OipRDDinoSaric/Complex-system-for-powering-digital-circuits-and-analogue-circuits-susceptible-to-noise/BoM_Zavrsni_rad[2018]Dino_Saric.xlsx

Value | Designator | Description | Case Style | Manufacturer | Order Code | Quantity | Price, GBP | Total price | Link:
 | U4 | LM2675M-5.0 - Buck (Step Down) Switching Regulator, Fixed, 6.5V-40V In, 5V And 1A Out, SOIC-8 | SOIC-8 | TEXAS INSTRUMENTS | 9489746 | 2 | 4,21 | 8.42 | http://export.farnell.com/texas-instruments/lm2675m-5-0/switching-reg-1a-5-0v-smd-2675/dp/9489746?st=LM2675
100u | L2 | SRF0703A-101M - Inductor, Coupled, 100 µH, 20%, 0.715 ohm, 730 mA, 7.6mm x 7.6mm x 3.4mm | Datasheet | BOURNS | 2455003 | 2 | 0,863 | 1.726 | http://export.farnell.com/bourns/srf0703a-101m/inductor-coupled-100uh-20-0-73a/dp/2455003
47u | C10 | C1210C476M9PACTU - SMD Multilayer Ceramic Capacitor, 1210 [3225 Metric], 47 µF, 6.3 V, ± 20%, X5R, C Series | 1210 | KEMET | 1108327 | 2 | 0,897 | 1.794 | http://export.farnell.com/kemet/c1210c476m9pactu/cap-mlcc-x5r-47uf-6-3v-1210/dp/1108327
- | D4 | NSVBAT54LT1G - Small Signal Schottky Diode, Single, 30 V, 200 mA, 800 mV, 600 mA, 150 °C | SOT-23 | ON SEMICONDUCTOR | 2774594 | 5 | 0,0366 | 0.183 | http://export.farnell.com/on-semiconductor/nsvbat54lt1g/diode-schottky-aec-q101-30v-sot/dp/2774594
100u | C9 | TPSD107K010R0100... - Surface Mount Tantalum Capacitor, 100 µF, 10 V, TPS Series, ± 10%, 2917 [7343 Metric] | 2917 | AVX | 1462462 | 2 | 0,922 | 1.844 | http://export.farnell.com/avx/tpsd107k010r0100/cap-tant-100uf-10v-case-d/dp/1462462
0,01u | C8 | 0603B103K250CT - SMD Multilayer Ceramic Capacitor, 0603 [1608 Metric], 0.01 µF, 25 V, ± 10%, X7R | 0603 | WALSIN | 2496827 | 10 | 0,0129 | 0.129 | http://export.farnell.com/walsin/0603b103k250ct/capacitor-mlcc-x7r-0-01uf-25v/dp/2496827
 |  |  |  |  |  |  |  | 0
 | U1 | TL2575-12IKTTR - Buck (Step Down) Switching Regulator, Fixed, 4.75V-40V In, 12V And 1A Out, TO-263-5 | T0-263-5 | TEXAS INSTRUMENTS | 1755279 | 2 | 1,69 | 3.38 | http://export.farnell.com/texas-instruments/tl2575-12ikttr/ic-stp-dwn-sw-v-reg-12v-d2pak/dp/1755279?st=TL2575
100u | C1 | EEEFPV101XAP - SMD Aluminium Electrolytic Capacitor, Radial Can - SMD, 100 µF, 35 V, 0.16 ohm, FP Series | Datasheet | PANASONIC ELECTRONIC COMPONENTS | 1539501 | 2 | 0,395 | 0.79 | http://export.farnell.com/panasonic-electronic-components/eeefpv101xap/cap-alu-elec-100uf-35v-smd/dp/1539501
470u | C2 | EEEFK1V471SP - SMD Aluminium Electrolytic Capacitor, Radial Can - SMD, 470 µF, 35 V, 0.08 ohm, FKS Series | Datasheet | PANASONIC ELECTRONIC COMPONENTS | 2507737 | 2 | 0,959 | 1.918 | http://export.farnell.com/panasonic-electronic-components/eeefk1v471sp/cap-alu-elec-470uf-35v-rad-can/dp/2507737
- | D1 | Kao D4 u retku 6 | SOT-23 | ON SEMICONDUCTOR | 2774594 | 0 | 0,0366 | 0 | http://export.farnell.com/on-semiconductor/nsvbat54lt1g/diode-schottky-aec-q101-30v-sot/dp/2774594
680u | L1 | MSS1278T-684KLB - Power Inductor (SMD), 680 µH, 750 µA, Shielded, 1.24 A, MSS1278T Series, 12mm x 12mm x 7.8mm | Datasheet | COILCRAFT | 2288523 | 2 | 0,804 | 1.608 | http://export.farnell.com/coilcraft/mss1278t-684klb/inductor-pwr-680uh-0-75a-10-1/dp/2288523
 |  |  |  |  |  |  |  | 0
- | U2 | LP2992AIM5-5.0/NOPB - Fixed LDO Voltage Regulator, 2.2V to 16V, 450mV Dropout, 5Vout, 250mAout, SOT-23-5 | SOT-23 | TEXAS INSTRUMENTS | 1685561 | 2 | 0,818 | 1.636 | http://export.farnell.com/texas-instruments/lp2992aim5-5-0-nopb/ic-ldo-reg/dp/1685561?st=LP2992
0,1u | C4 | VJ0805Y104JCAAJ - SMD Multilayer Ceramic Capacitor, IR Reflow, 0805 [2012 Metric], 0.1 µF, 50 V, ± 5%, X7R | 0805 | VISHAY | 2672814 | 2 | 0,361 | 0.722 | http://export.farnell.com/vishay/vj0805y104jcaaj/cap-mlcc-x7r-0-1uf-50v-0805/dp/2672814
47u | C6 | C1210C476M9PACTU - SMD Multilayer Ceramic Capacitor, 1210 [3225 Metric], 47 µF, 6.3 V, ± 20%, X5R, C Series | 1210 | KEMET | 1108327 | 2 | 0,897 | 1.794 | http://export.farnell.com/kemet/c1210c476m9pactu/cap-mlcc-x5r-47uf-6-3v-1210/dp/1108327
10u | C5 | 1210X106K250CT - SMD Multilayer Ceramic Capacitor, 1210 [3225 Metric], 10 µF, 25 V, ± 10%, X5R | 1210 | WALSIN | 2497182 | 2 | 0,419 | 0.838 | http://export.farnell.com/walsin/1210x106k250ct/capacitor-mlcc-x5r-10uf-25v-1210/dp/2497182
 |  |  |  |  |  |  |  | 0
- | U3 | PIC16F1459-I/P - 8 Bit Microcontroller, Flash, PIC16F145x, 48 MHz, 14 KB, 1 KB, 20 Pins, DIP | DIP-20 | MICROCHIP | 2305816 | 2 | 1,81 | 3.62 | http://export.farnell.com/microchip/pic16f1459-i-p/mcu-8bit-pic16-48mhz-dip-20/dp/2305816
0,1u | C3 | VJ0805Y104JCAAJ - SMD Multilayer Ceramic Capacitor, IR Reflow, 0805 [2012 Metric], 0.1 µF, 50 V, ± 5%, X7R | 0805 | VISHAY | 2672814 | 2 | 0,361 | 0.722 | http://export.farnell.com/vishay/vj0805y104jcaaj/cap-mlcc-x7r-0-1uf-50v-0805/dp/2672814
470n | C7 | 885012007025 - SMD Multilayer Ceramic Capacitor, 0805 [2012 Metric], 4700 pF, 16 V, ± 5%, C0G / NP0 | 0805 | WURTH ELEKTRONIK | 2812146 | 5 | 0,124 | 0.62 | http://export.farnell.com/wurth-elektronik/885012007025/cap-mlcc-c0g-4700pf-16v-0805/dp/2812146
- | J1, J2, J4, J5, J6, J7, J9, J10 | 2211S-02G - Board-To-Board Connector, Vertical, 2.54 mm, 2 Contacts, Header, 2211S Series, Through Hole, 1 Rows | Through hole, 01x02, 2,54 mm | MULTICOMP | 1593411 | 16 | 0,0204 | 0.3264 | http://export.farnell.com/multicomp/2211s-02g/header-1-row-vert-2way/dp/1593411
- | J8 | TSM-106-01-L-SH - Board-To-Board Connector, 2.54 mm, 6 Contacts, Header, TSM Series, Surface Mount, 1 Rows | Through hole, 01x06, 2,54 mm | SAMTEC | 2667444 | 2 | 0,671 | 1.342 | http://export.farnell.com/samtec/tsm-106-01-l-sh/connector-header-6pos-1row-2-54mm/dp/2667444
- | J12 | 90120-0768 - Board-To-Board Connector, Vertical, 2.54 mm, 8 Contacts, Header, C-Grid III 90120 Series | Through hole, 01x08, 2,54 mm | MOLEX | 9733345 | 2 | 0,45 | 0.9 | http://export.farnell.com/molex/90120-0768/header-vertical-1row-8way/dp/9733345
- | J11 | 2211S-03G - Board-To-Board Connector, Vertical, 2.54 mm, 3 Contacts, Header, 2211S Series, Through Hole, 1 Rows | Through hole, 01x03, 2,54 mm | MULTICOMP | 1593412 | 2 | 0,0269 | 0.0538 | http://export.farnell.com/multicomp/2211s-03g/header-1-row-vert-3way/dp/1593412
- | J3 | ZX62-B-5PA(33) - USB Connector, Micro USB Type B, USB 2.0, Receptacle, 5 Ways, Surface Mount, Right Angle | Surface Mount, Right Angle | HIROSE(HRS) | 2554978 | 2 | 0,38 | 0.76 | http://export.farnell.com/hirose-hrs/zx62-b-5pa-33/micro-usb-2-0-type-b-rcpt-smt/dp/2554978
- | D2, D3 | KPT-1608EC - LED, Low Power, Red, SMD, 0.8mm x 1.6mm, 20 mA, 2 V, 617 nm | 0603 | KINGBRIGHT | 2099221 | 5 | 0,0375 | 0.1875 | http://export.farnell.com/kingbright/kpt-1608ec/led-0603-red-15mcd-625nm/dp/2099221
150 | R1, R2 | MCWR08X1500FTL - SMD Chip Resistor, 150 ohm, MCWR Series, 150 V, Thick Film, 0805 [2012 Metric], 125 mW | 0805 | MULTICOMP | 2447574 | 10 | 0,006 | 0.06 | http://export.farnell.com/multicomp/mcwr08x1500ftl/res-thick-film-150r-1-0-125w-0805/dp/2447574
- | U3 | 2227MC-20-03-07-F1 - IC & Component Socket, 20 Contacts, DIP Socket, 2.54 mm, 2227MC Series, 7.62 mm, Phosphor Bronze | DIP-20 | MULTICOMP | 1103848 | 2 | 0,457 | 0.914 | http://export.farnell.com/multicomp/2227mc-20-03-07-f1/socket-ic-dil-0-3-20way/dp/1103848
 |  |  |  |  |  |  |  | 0
1,6k | R3 | MCMR04X162 JTL - SMD Chip Resistor, Ceramic, 1.6 kohm, MCMR Series, 50 V, Thick Film, 0402 [1005 Metric], 62.5 mW | 0402 | MULTICOMP | 2072674 | 10 | 0,0017 | 0.017 | http://export.farnell.com/multicomp/mcmr04x162-jtl/res-ceramic-1k6-5-0-0625w-0402/dp/2072674
- | D5, D6 | LGT67K-H2K1-24-Z - LED, Hyper TOPLED®, Green, SMD, 2.4mm, 2 mA, 1.8 V, 570 nm | Datasheet | OSRAM | 1226376 | 5 | 0,174 | 0.87 | http://export.farnell.com/osram/lgt67k-h2k1-24-z/led-smd-green-9mcd-570nm/dp/1226376
5,1k | R4 | MCWR08X5101FTL - SMD Chip Resistor, 5.1 kohm, MCWR Series, 150 V, Thick Film, 0805 [2012 Metric], 125 mW | 0805 | MULTICOMP | 2447692 | 10 | 0,006 | 0.06 | http://export.farnell.com/multicomp/mcwr08x5101ftl/res-thick-film-5k1-1-0-125w-0805/dp/2447692
 |  |  |  |  |  |  |  | 0
 |  |  |  |  |  |  |  | 0
 |  |  |  |  |  |  |  | 0
 |  |  |  |  |  |  | SUMA, GPB | 37.2347
