OipRDDinoSaric/Complex-system-for-powering-digital-circuits-and-analogue-circuits-susceptible-to-noise/Dodatni_BoM_Zavrsni_rad[2018]Dino_Saric.xlsx

Value | Designator | Description | Case Style | Manufacturer | Order Code | Quantity | Price, GBP | Total price, GPB | Link:
0,1u | C3 | MC0402B104J160CT - SMD Multilayer Ceramic Capacitor, 0402 [1005 Metric], 0.1 µF, 16 V, ± 5%, X7R, MC Series | 0402 | MULTICOMP | 2627342 | 10 | 0.0141 | 0.141 | http://export.farnell.com/multicomp/mc0402b104j160ct/cap-mlcc-x7r-0-1uf-16v-0402/dp/2627342
5,1K | R4 | ERJ2GEJ512X - SMD Chip Resistor, 5.1 kohm, ERJ2G Series, 50 V, Thick Film, 0402 [1005 Metric], 100 mW | 0402 | PANASONIC | 2059235 | 10 | 0.0173 | 0.173 | http://export.farnell.com/panasonic-electronic-components/erj2gej512x/res-thick-film-5k1-5-0-1w-0402/dp/2059235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
0,1u | C3 | ZAMJENSKA - MC0402X104K100CT - SMD Multilayer Ceramic Capacitor, 0402 [1005 Metric], 0.1 µF, 10 V, ± 10%, X5R, MC Series | 0402 | MULTICOMP | 1759380 | 10 | 0.0092 | 0.092 | http://export.farnell.com/multicomp/mc0402x104k100ct/cap-mlcc-x5r-100nf-10v-0402/dp/1759380
10,2k | R4 | Za 2 u paralelu - ERJ2RKF1022X - SMD Chip Resistor, 10.2 kohm, ERJ2R Series, 50 V, Thick Film, 0402 [1005 Metric], 100 mW | 0402 | PANASONIC ELECTRONIC COMPONENTS | 2302740 | 10 | 0.023 | 0.23 | http://export.farnell.com/te-connectivity/rp73pf1e10k2btdf/res-thin-film-10k2-0-1-0-1w-0402/dp/2838466RL
15,4k | R4 | Za 3 u paralelu - SMD Chip Resistor, 15.4 kohm, ERJ2R Series, 50 V, Thick Film, 0402 [1005 Metric], 100 mW | 0402 | PANASONIC ELECTRONIC COMPONENTS | 2302756 | 10 | 0,0207 | 0.207 | http://export.farnell.com/panasonic-electronic-components/erj2rkf1542x/res-thick-film-15k4-1-0-1w-0402/dp/2302756
5,1k | R4 | through hole - MCMF006FF5101A50 - Through Hole Resistor, 5.1 kohm, MCMF Series, 600 mW, ± 1%, Axial Leaded, 250 V | Through Hole | MULTICOMP | 2401773 | 10 | 0.0269 | 0.269 | http://export.farnell.com/multicomp/mcmf006ff5101a50/resistor-metal-film-5-1kohm-1/dp/2401773
 |  |  |  |  |  |  | SUMA | 1.112
