OipRDDinoSaric/Complex-system-for-powering-digital-circuits-and-analogue-circuits-susceptible-to-noise/(list of files, cad)

Other CAD files:
Upravljanje/Backup - problemi/MPLAB/USB-to-SPI.x/dist/LPCUSBDK_16F1459/production/USB-to-SPI.x.production.obj
Upravljanje/MPLAB/ADC/ADC.X/dist/LPCUSBDK_16F1459/production/USB-to-SPI.x.production.obj
Upravljanje/MPLAB/ADC/ADC.X/dist/LPCUSBDK_16F1459/production/ADC.X.production.obj
