OipRDDinoSaric/Complex-system-for-powering-digital-circuits-and-analogue-circuits-susceptible-to-noise/KiCad/Zavrsni.kicad_pcb

## KiCad design KiCad/Zavrsni.kicad_pcb (2018-10-11)

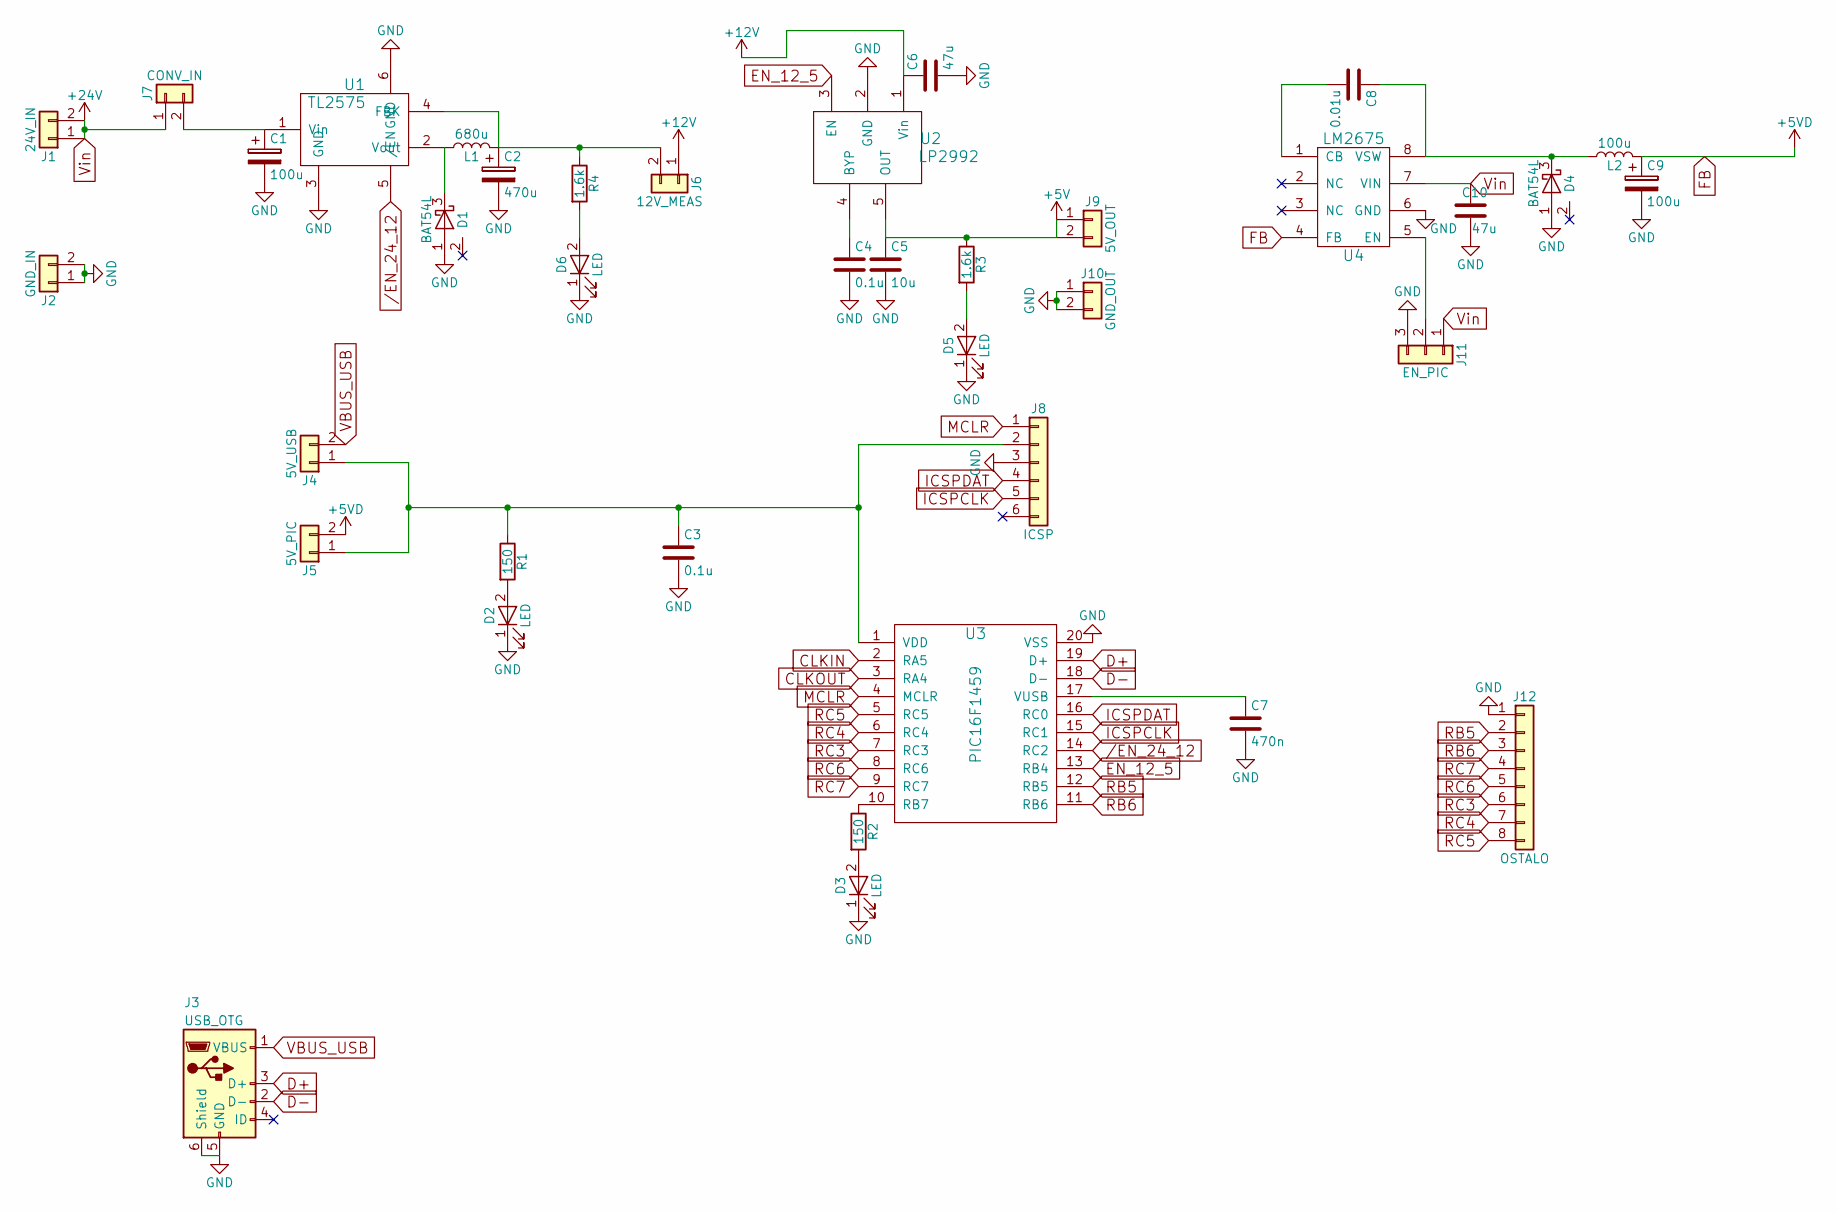
[picture p27: schematic Zavrsni.sch]

Parts:
C1: 100u; CP_Elec_6.3x7.7
C2: 470u; CP_Elec_10x10.5
C3: 0.1u; C_0402
C4: 0.1u; C_0805_HandSoldering
C5: 10u; C_1210_HandSoldering
C6, C10: 47u; C_1210_HandSoldering
C7: 470n; C_0805_HandSoldering
C8: 0.01u; C_0603_HandSoldering
C9: 100u; SM2917_POL
D1, D4: BAT54L; SOT-23_Handsoldering
D2, D3: LED; C_0603_HandSoldering
D5, D6: LED; Zelena dioda
J1: 24V_IN; Pin_Header_Straight_1x02_Pitch2.54mm
J2: GND_IN; Pin_Header_Straight_1x02_Pitch2.54mm
J3: USB_OTG; USB_Micro-B
J4: 5V_USB; Pin_Header_Straight_1x02_Pitch2.54mm
J5: 5V_PIC; Pin_Header_Straight_1x02_Pitch2.54mm
J6: 12V_MEAS; Pin_Header_Straight_1x02_Pitch2.54mm
J7: CONV_IN; Pin_Header_Straight_1x02_Pitch2.54mm
J8: ICSP; Pin_Header_Straight_1x06_Pitch2.54mm
J9: 5V_OUT; Pin_Header_Straight_1x02_Pitch2.54mm
J10: GND_OUT; Pin_Header_Straight_1x02_Pitch2.54mm
J11: EN_PIC; Pin_Header_Straight_1x03_Pitch2.54mm
J12: OSTALO; Pin_Header_Straight_1x08_Pitch2.54mm
L1: 680u; Coilcraft MSS1278T-684KLB 680uH
L2: 100u; Bourns_SRF0703A-101M_100u
R1, R2: 150; R_0805_HandSoldering
R3, R4: 1.6k; R_0402
U1: TL2575; TO-263-5
U2: LP2992; SOT-23-5_HandSoldering
U3: PIC16F1459; DIP-20_W7.62mm_LongPads
U4: LM2675; SOIC-8_3.9x4.9mm_Pitch1.27mm

Connections:
+5V: C5.1, J9.1, J9.2, R3.1, U2.5 (OUT)
+12V: C6.1, J6.1, U2.1 (Vin)
/EN_24_12: U1.5 (/EN), U3.14 (RC2)
CLKIN: U3.2 (RA5)
CLKOUT: U3.3 (RA4)
D+: J3.3 (D+), U3.19 (D+)
D-: J3.2 (D-), U3.18 (D-)
EN_12_5: U2.3 (EN), U3.13 (RB4)
FB: C9.1, J5.2, L2.2, U4.4 (FB)
GND: C1.2, C2.2, C3.2, C4.2, C5.2, C6.2, C7.2, C9.2, C10.1, D1.1 (A), D2.1 (K), D3.1 (K), D4.1 (A), D5.1 (K), D6.1 (K), J2.1, J2.2, J3.5 (GND), J3.6 (Shield), J8.3, J10.1, J10.2, J11.3, J12.1, U1.3 (GND), U1.6 (GND), U2.2 (GND), U3.20 (VSS), U4.6 (GND)
ICSPCLK: J8.5, U3.15 (RC1)
ICSPDAT: J8.4, U3.16 (RC0)
MCLR: J8.1, U3.4 (MCLR)
unnamed: C1.1, J7.2, U1.1 (Vin)
unnamed: C2.1, J6.2, L1.2, R4.1, U1.4 (FBK)
unnamed: C3.1, J4.1, J5.1, J8.2, R1.1, U3.1 (VDD)
unnamed: C4.1, U2.4 (BYP)
unnamed: C7.1, U3.17 (VUSB)
unnamed: C8.1, D4.3 (K), L2.1, U4.8 (VSW)
unnamed: C8.2, U4.1 (CB)
unnamed: D1.3 (K), L1.1, U1.2 (Vout)
unnamed: D2.2 (A), R1.2
unnamed: D3.2 (A), R2.2
unnamed: D5.2 (A), R3.2
unnamed: D6.2 (A), R4.2
unnamed: J11.2, U4.5 (EN)
unnamed: R2.1, U3.10 (RB7)
RB5: J12.2, U3.12 (RB5)
RB6: J12.3, U3.11 (RB6)
RC3: J12.6, U3.7 (RC3)
RC4: J12.7, U3.6 (RC4)
RC5: J12.8, U3.5 (RC5)
RC6: J12.5, U3.8 (RC6)
RC7: J12.4, U3.9 (RC7)
VBUS_USB: J3.1 (VBUS), J4.2
Vin: C10.2, J1.1, J1.2, J7.1, J11.1, U4.7 (VIN)

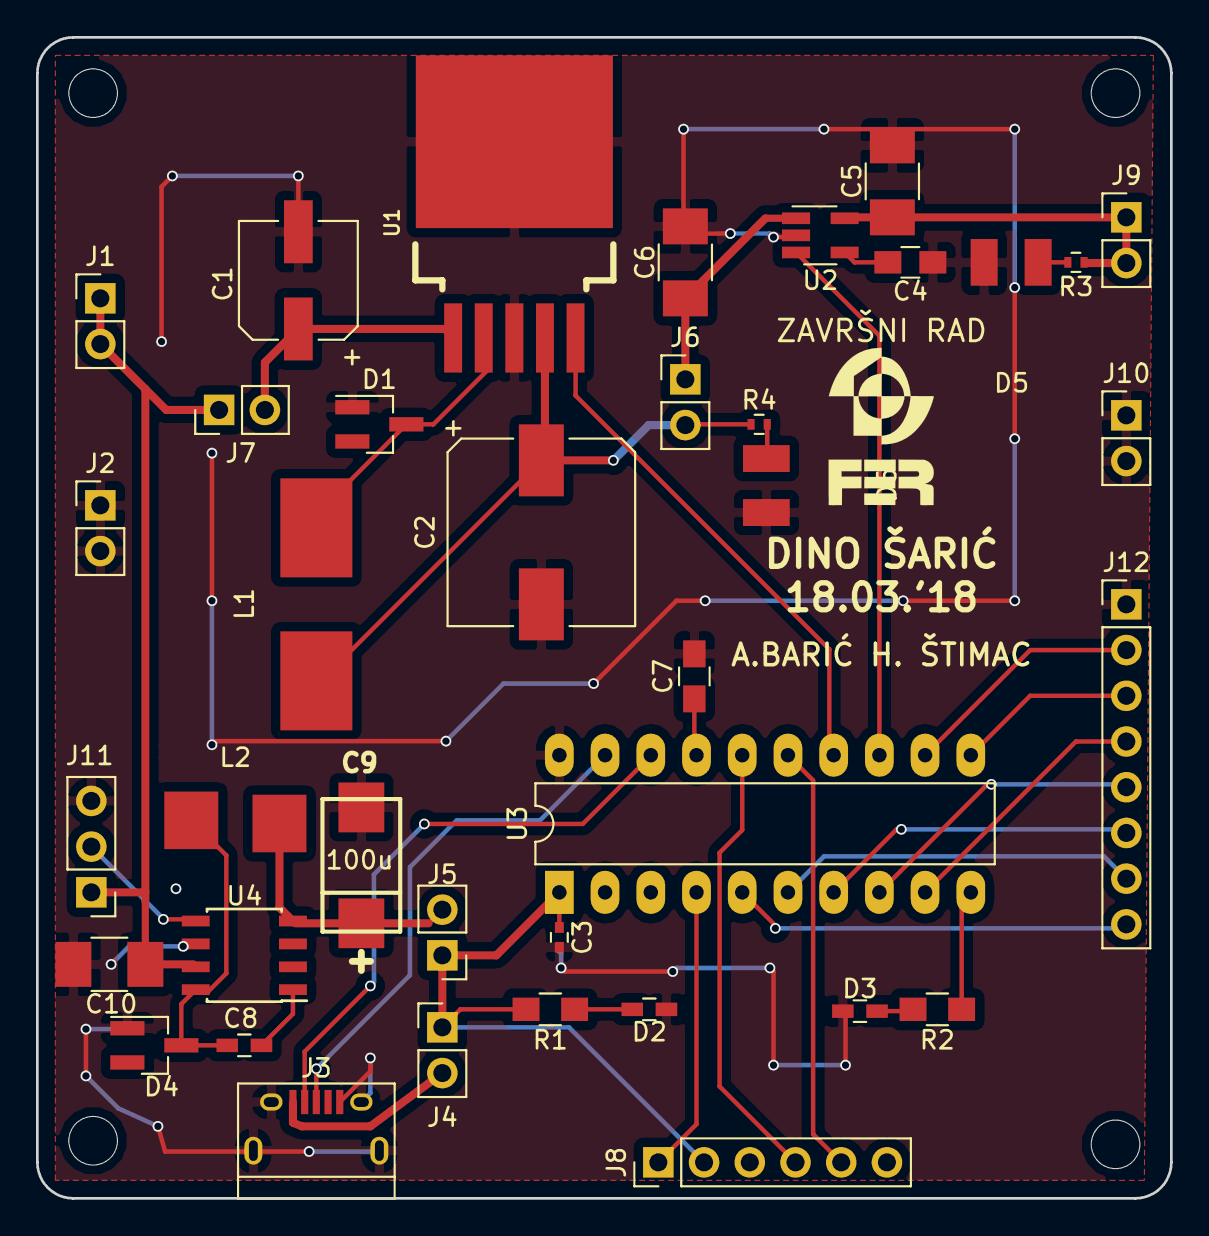
[picture p28: board Zavrsni.kicad_pcb from above]

Board: 2 copper layers, 63.0 x 64.5 mm, 39 parts (0 on the bottom side), 34 nets.

Other parts of the board:
VAL: FERlogov3NEGBMP_025in
