OipRDDinoSaric/Complex-system-for-powering-digital-circuits-and-analogue-circuits-susceptible-to-noise/Upravljanje/MPLAB/ADC/python_main.py

# -*- coding: utf-8 -*-
import numpy as np
from numpy import *
import serial

# port init
ser = serial.Serial()
ser.port = 'COM4'
ser.baudrate = 1200
ser.timeout = 0.1

# generate data
data = 'radi2!'
##data = bytes.fromhex(data)
data = bytearray(data, 'utf-8')

# write
ser.open()

for i in range(1):
    ser.write(data)
mm = ser.read(64)
##mm = hex(int.from_bytes(mm, 'big'))
mm = mm.decode()

print('returned:', mm)

ser.close()
